mikeoverbay/auto_scasnner_device/model/rack.stl

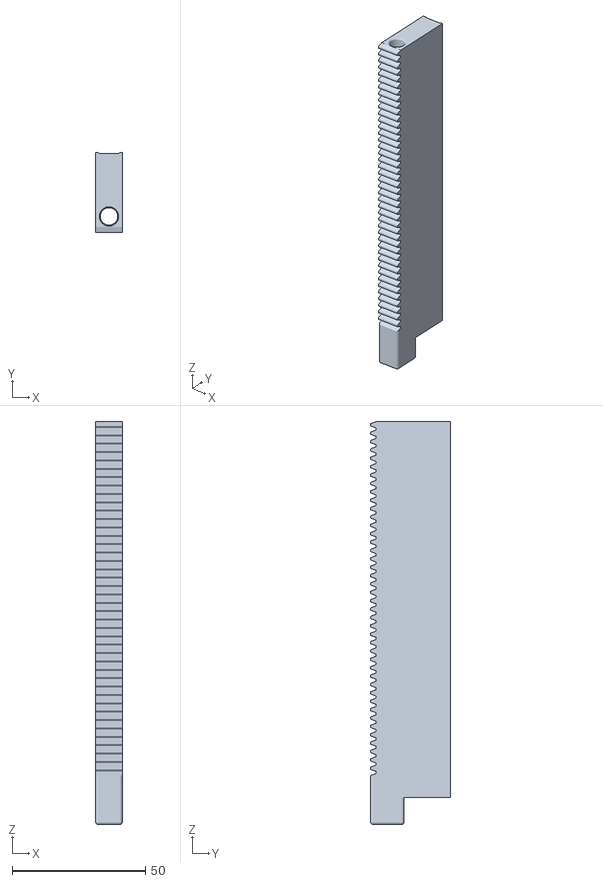
[picture p6: CAD file, 2026-11-03]
model/rack.stl
10.0 x 30.0 x 151.2
