mikeoverbay/auto_scasnner_device/model/body.stl

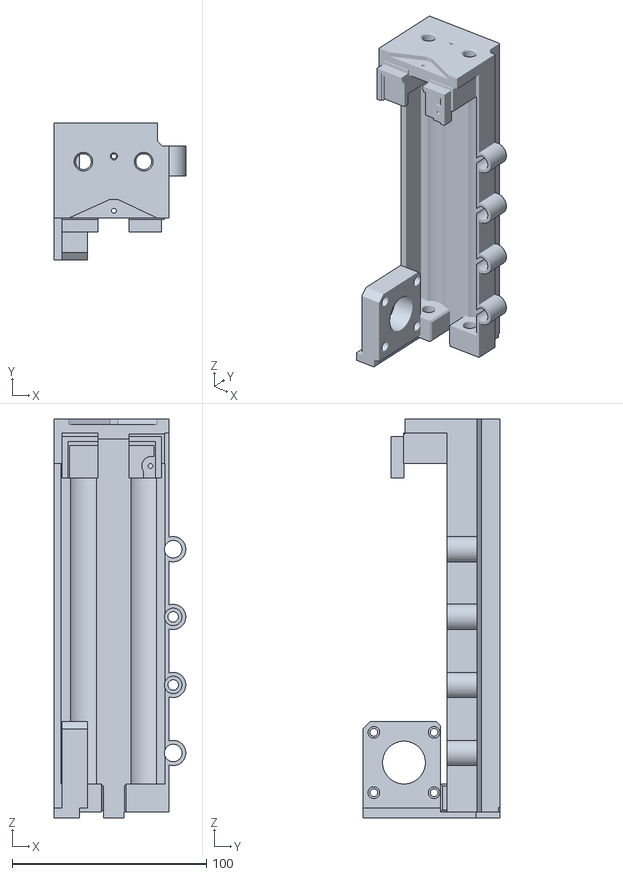
[picture p7: CAD file, 2026-11-03]
model/body.stl
67.7 x 70.7 x 205.2
