mikeoverbay/auto_scasnner_device/model/probe_tip.stl

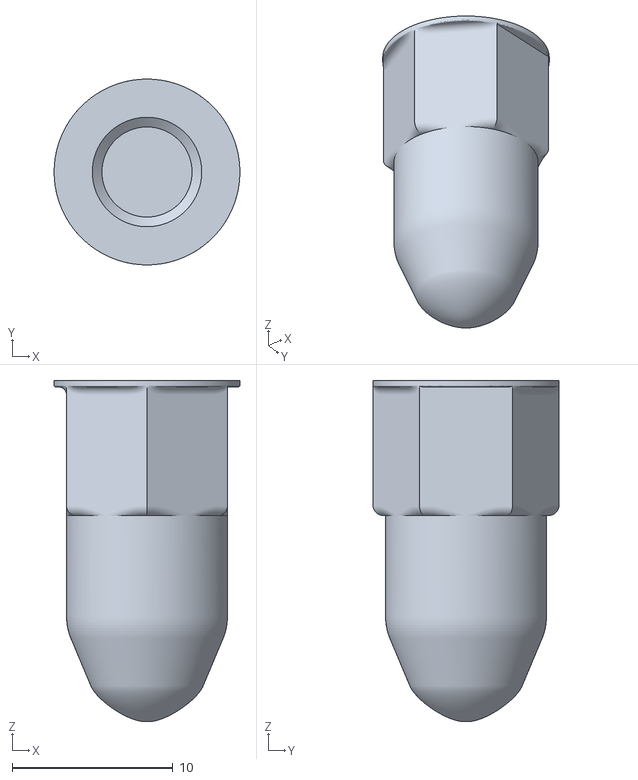
[picture p8: CAD file, 2026-11-03]
model/probe_tip.stl
11.5 x 11.6 x 21.2
