mikeoverbay/auto_scasnner_device/model/cover.stl

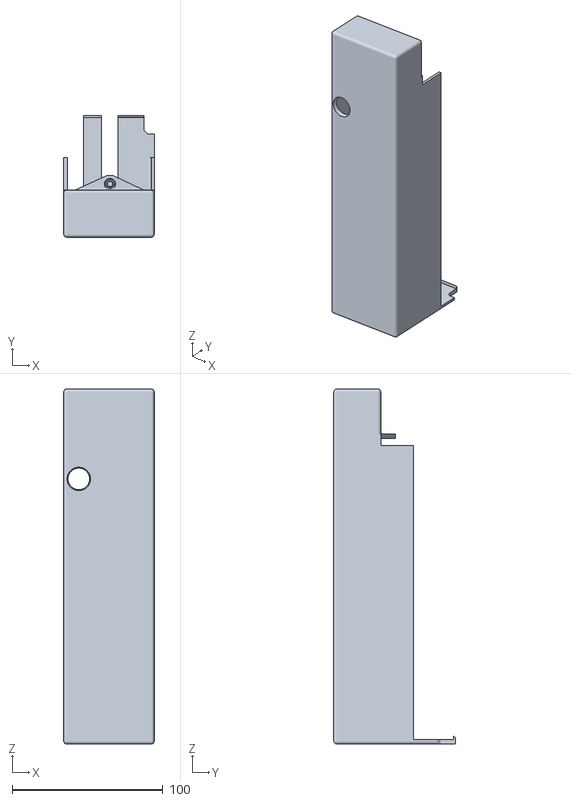
[picture p9: CAD file, 2026-11-03]
model/cover.stl
60.0 x 80.5 x 235.2
