mikeoverbay/auto_scasnner_device/model/led_bezel.stl

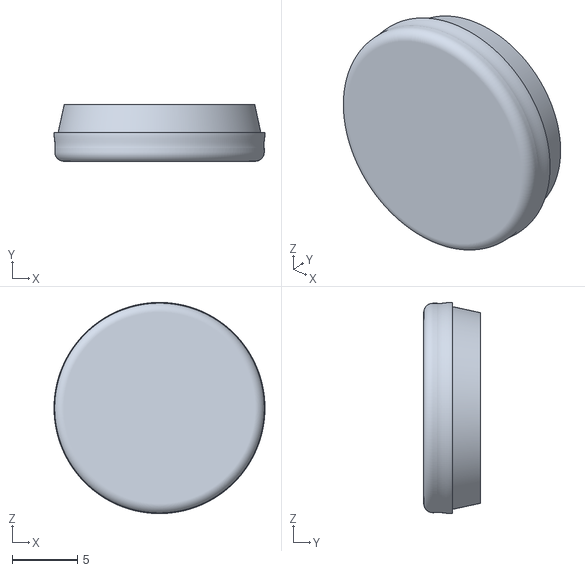
[picture p10: CAD file, 2026-11-03]
model/led_bezel.stl
16.2 x 4.33 x 16.2
