mikeoverbay/auto_scasnner_device/model/cable _clamp.stl

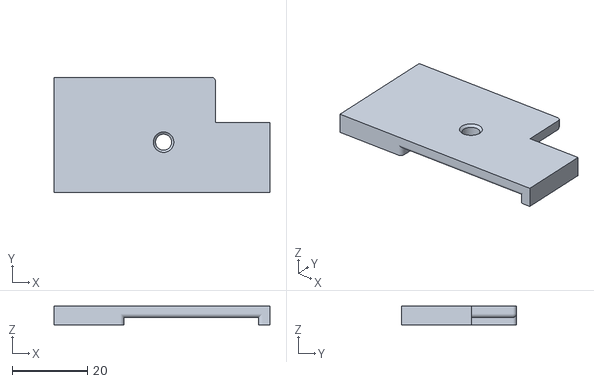
[picture p11: CAD file, 2026-11-03]
model/cable _clamp.stl
57.5 x 30.7 x 5.00
