mikeoverbay/auto_scasnner_device/model/fit_test_rack.stl

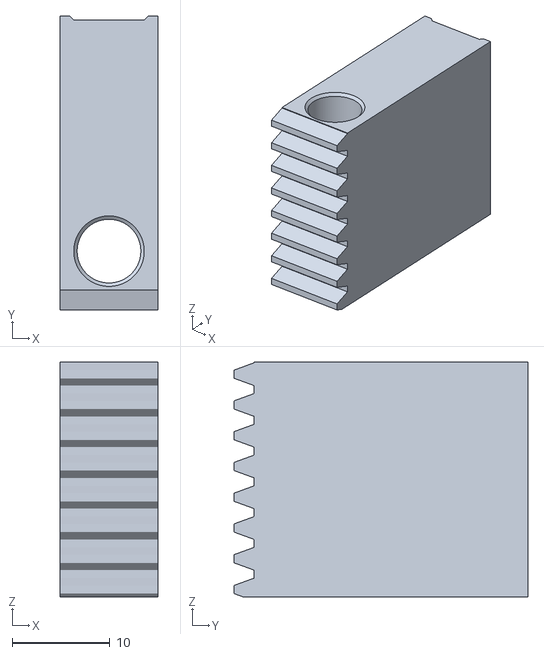
[picture p12: CAD file, 2026-11-03]
model/fit_test_rack.stl
10.0 x 30.0 x 24.0
