mikeoverbay/auto_scasnner_device/model/slide.stl

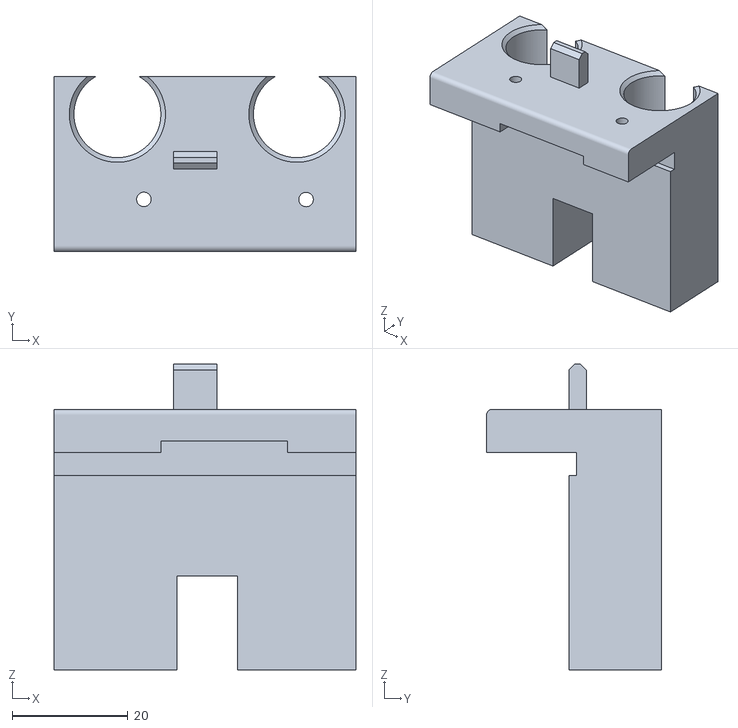
[picture p13: CAD file, 2026-11-03]
model/slide.stl
52.1 x 30.2 x 52.8
