mikeoverbay/auto_scasnner_device/model/motorWireConduite.stl

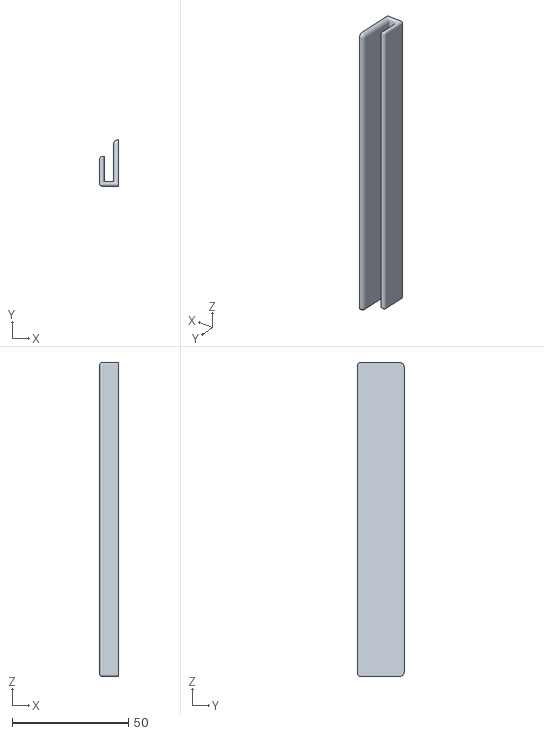
[picture p14: CAD file, 2026-11-03]
model/motorWireConduite.stl
8.00 x 20.0 x 135.0
