mikeoverbay/auto_scasnner_device/model/Auto Probe Addon.step

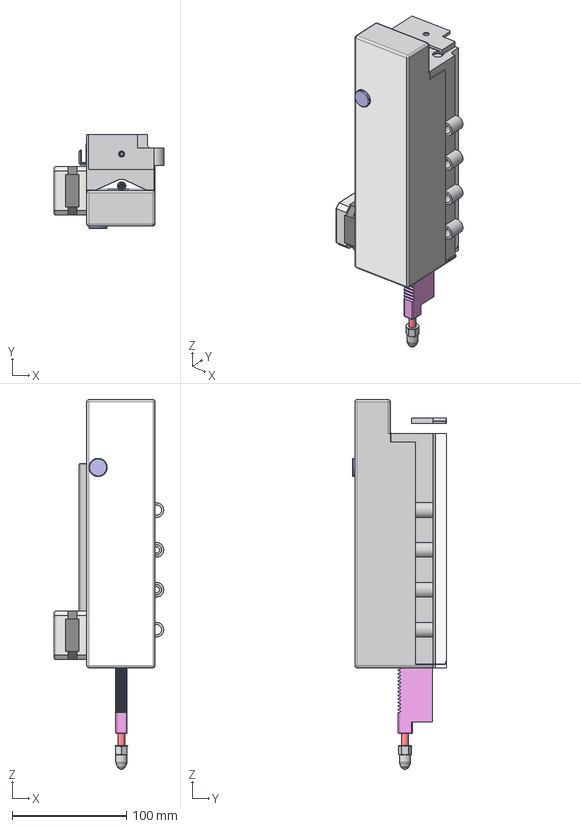
[picture p15: CAD file, 2026-11-02]
model/Auto Probe Addon.step
96.2 x 82.7 x 324.4 mm
cover
opto travel https://www.amazon.com/dp/B07PMW2QMT
LED_D5.0mm-4_RGB_Wide_Pins https://www.pololu.com/product/2535
JST_XH_B3B-XH-A_1x03_P2.50mm_Vertical x 2
JST_XH_B4B-XH-A_1x04_P2.50mm_Vertical
probe board_copper
probe board_PCB https://www.amazon.com/dp/B07R49F3MH
A4988-Stepper-Driver-WithPins.stp
ARDUINO PRO MICRO.stp
2 pin terminal block.STEP
C_Rect_L7.0mm_W2.0mm_P5.00mm
CP_Radial_D10.0mm_P5.00mm
NEAM 17 https://www.amazon.com/dp/B01N30ISYC
opto touch https://www.amazon.com/dp/B07PMW2QMT
