mikeoverbay/auto_scasnner_device/(commit log)

2026-11-02 Parts list from the Shapr3D model, the probe firmware, and a README
    BOM.md: bought parts with their source links and quantities, made parts,
    and the assembly tree, from Auto Probe Addon.step (2026-10-17).
    firmware/PROBE_OS: the copy from the CNC PC (2025-12-21; no A command yet,
    to be replaced by the newer OneDrive copy). README: pins and serial commands.
    Claude-Session: https://claude.ai/code/session_01R9xtK3pwj79dDGpTDmEKRq
    [PROBE_OS.ino]
2026-11-02 Parts list: source links for the bearings, electronics and threaded rod
    The bearings are LM8LUU (8 mm bore, 15 mm OD, 45 mm) with the full link;
    links for the Pro Micro, A4988, terminal block, JST-XH 3 and 4 pin, the
    100 uF and film capacitors and the M5 x 200 mm rod, from the user.
    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
2026-11-02 Add the 3D model (Shapr3D STEP, 15.9 MB) and point to it from the README
    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
    [Auto Probe Addon.step]
2026-11-02 Add pictures: the assembly, both sides of the probe board, and the two optical switches
    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
2026-11-03 README: making the probe board (cutter size, levelling, two-sided with registration holes), and the spindle it fits
    The registration sketch (images/registration-holes.png): two 1/4 in dowel holes on
    the board's centre line, 1/2 in past its top and bottom edges. Cutter advice from
    the pad sizes in the model (1.5-1.7 mm pads on 2.54 mm pitch).
    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
2026-11-03 README: the probe is 77.5 mm (3.051 in) from the spindle centre
    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
2026-11-03 README: set the A4988 current low, so a dead sensor stalls the motor instead of tearing it off
    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
2026-11-03 Add files via upload
    STLs added
    [body.stl, cable _clamp.stl, cover.stl, fit_test_rack.stl, led_bezel.stl, motorWireConduite.stl, probe_tip.stl, rack.stl]
